uddieforge/strumplate-replacement/20261028_113935.jpg

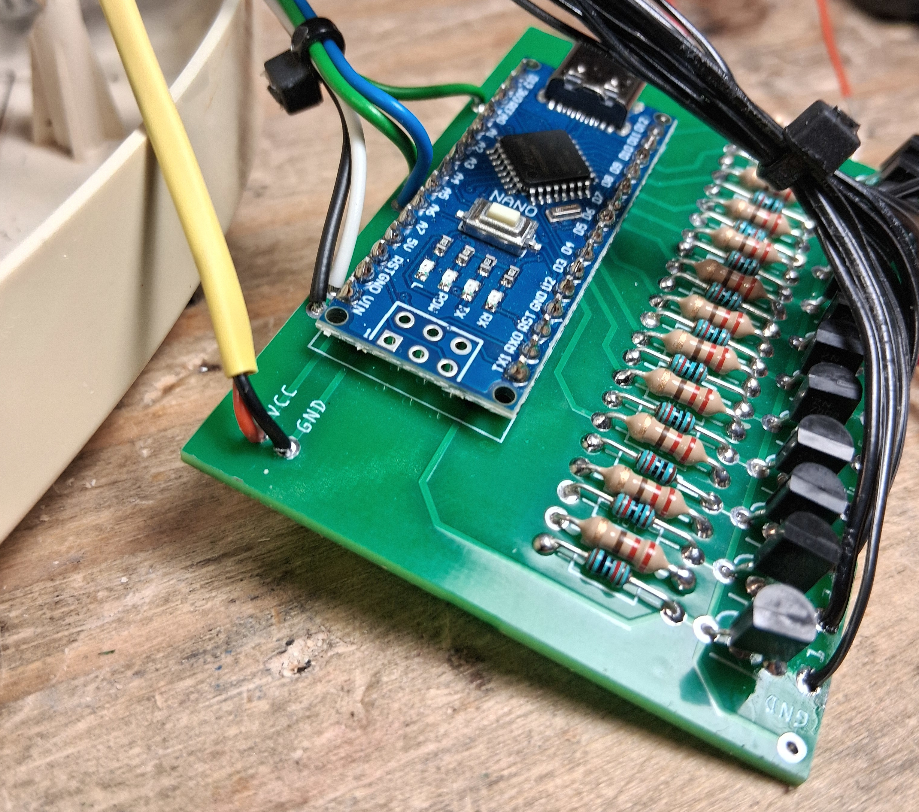
20261028_113935.jpg
