uddieforge/strumplate-replacement/20261028_113932.jpg

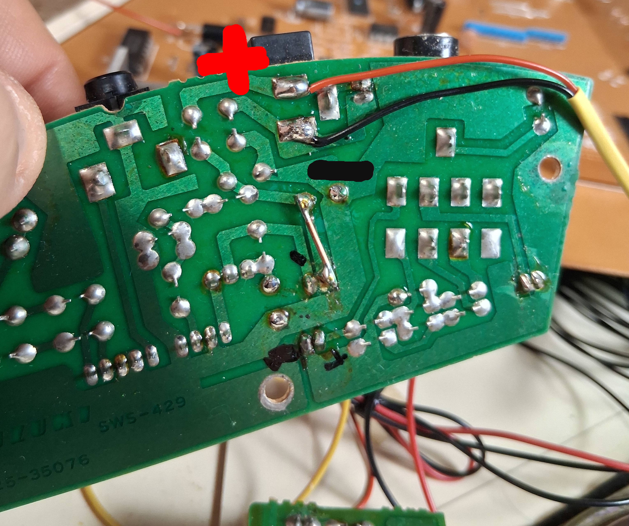
20261028_113932.jpg
