uddieforge/strumplate-replacement/Omnichord Schematic.pdf

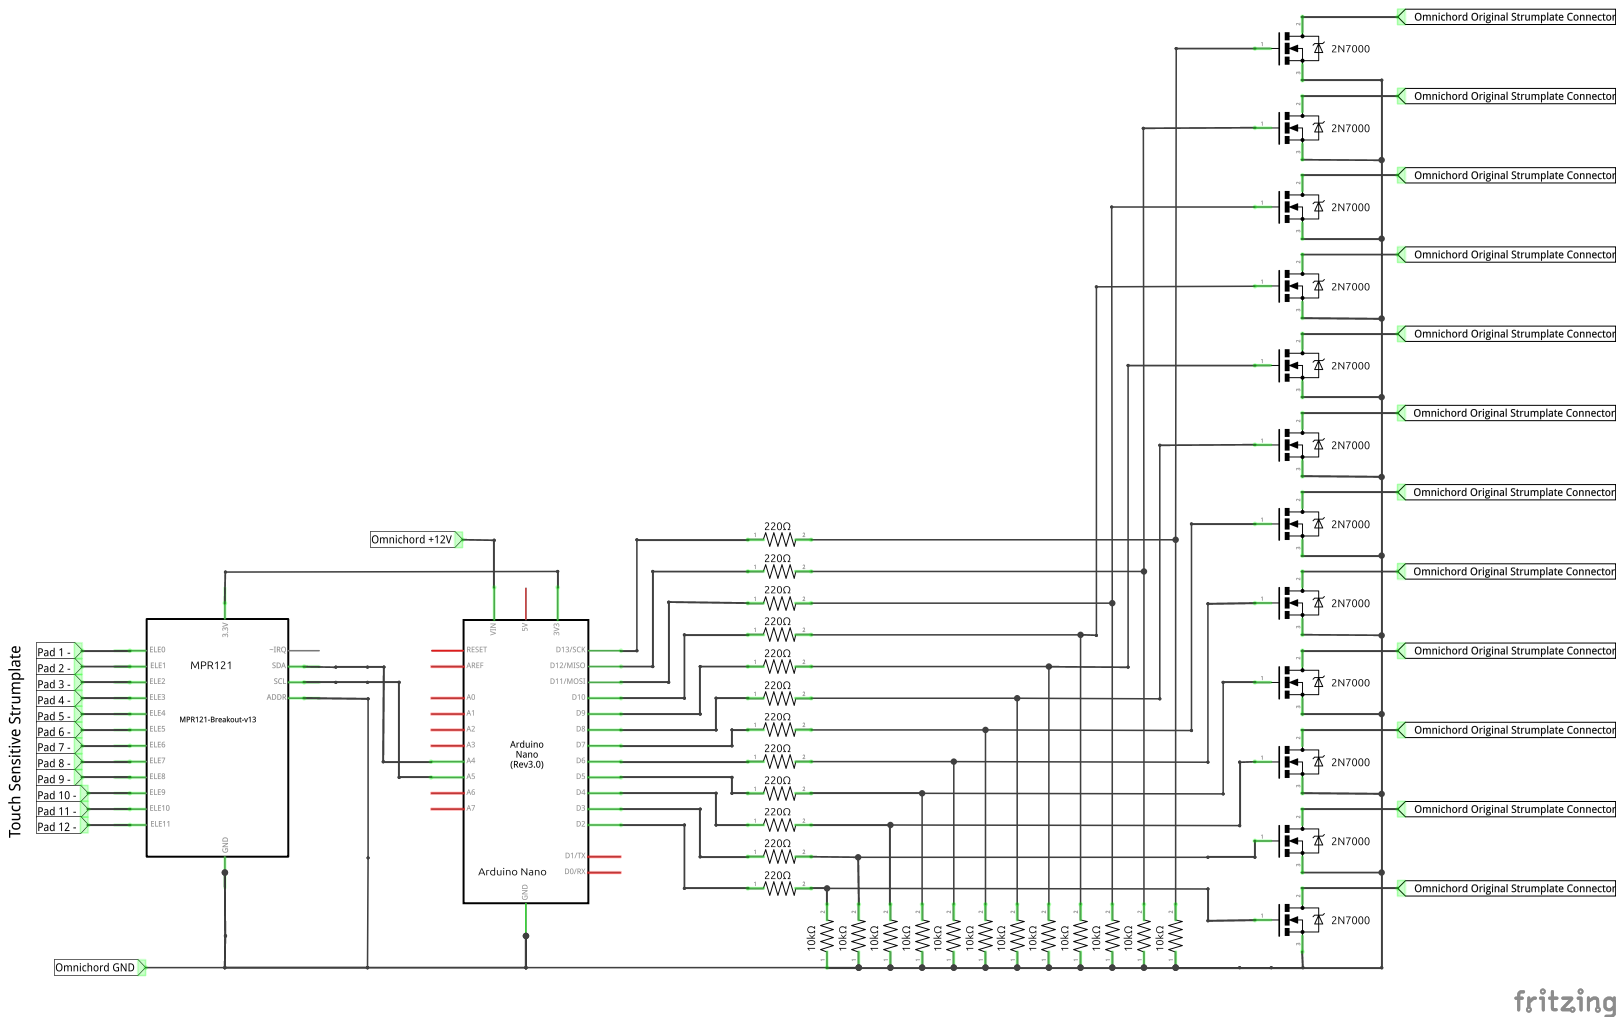
[picture p3: page 1]
