uddieforge/strumplate-replacement/(list of files, drawings)

Other design files:
Omnichord 2.fzz
Omnichord Schematic.fzz
Strumplate.fzz
