uddieforge/strumplate-replacement/(commit log)

2026-10-29 Enhance README with wiring details and limitations
    Added wiring instructions and project limitations to README.
2026-10-29 Add caution about wiring for capacitive sensing pads
    Added a caution about wiring to avoid triggering capacitive pads.
2026-10-29 Gerber file for the Arduino board
2026-10-29 Gerber File for the sensitive Strumplate PCB
2026-10-29 VCC and GND wiring
2026-10-29 Arduino board
2026-10-30 Omnichord Replacement Strumplate Schematic
2026-10-30 Fritzing Omnichord Schematic
    [Omnichord Schematic.fzz]
2026-10-30 Fritzing Strumplate File
    [Strumplate.fzz]
2026-10-30 Fritzing Omnichord Arduino Board
    [Omnichord 2.fzz]
2026-10-30 Gerber Files Arduino Board
2026-10-30 Gerber File Sensitive Strumplate
